octanisorg/Octanis5-Rack_MOSFET_driver/RPi_Hat.xlsx

Location | MPN/Seeed SKU | QTY
C1, C2 | 100u | 2
D1, D2, D3, D4, D5, D6, D7, D8 | MMSZ5237B-7-F | 8
D9, D10, D11, D12, D13, D14, D15, D16 | FM4004-W | 8
D25 | 1N5819HW-7-F | 1
Q1, Q2, Q3, Q4, Q5, Q6, Q7, Q8 | TSM3404 | 8
R1, R2, R3, R4, R5, R6, R7, R8 | 1k5 | 8
R9, R10, R11, R12, R13, R14, R15, R16 | 18k | 8
R17, R18, R19, R20, R21, R22, R23, R24 | 4k7 | 8
U1, U2, U3, U4, U5, U6, U7, U8 | VO615A-3 | 8
