octanisorg/Octanis5-Rack_MOSFET_driver/RPi_Hat.kicad_pcb

## KiCad design RPi_Hat.kicad_pcb (2017-12-09)

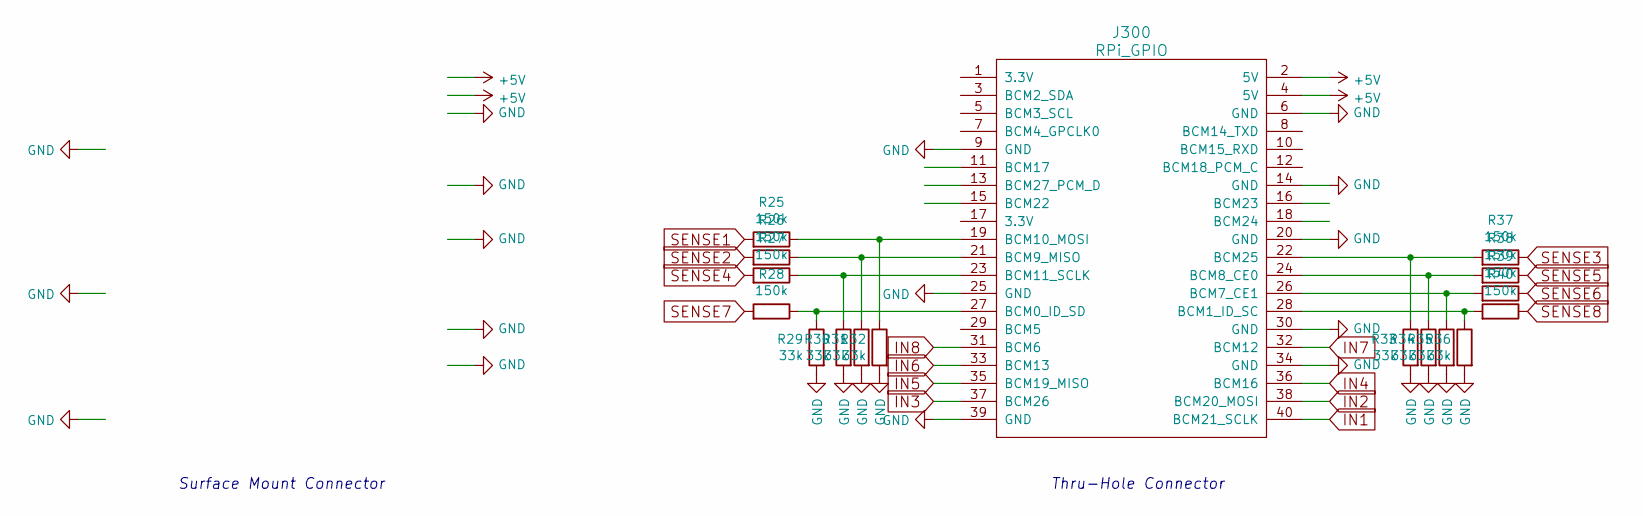
[picture p1: schematic RPi_GPIO.sch]

Parts:
J300: RPi_GPIO; Pin_Header_Straight_2x20; LCSC P/N C50982
R25, R26, R27, R28, R37, R38, R39, R40: 150k; R_0603; LCSC P/N C22807
R29, R30, R31, R32, R33, R34, R35, R36: 33k; R_0603; LCSC P/N C4216

Connections:
+5V: J300.2 (5V), J300.4 (5V); also elsewhere on the board
GND: J300.6 (GND), J300.9 (GND), J300.14 (GND), J300.20 (GND), J300.25 (GND), J300.30 (GND), J300.34 (GND), J300.39 (GND), R29.2, R30.2, R31.2, R32.2, R33.2, R34.2, R35.2, R36.2; also elsewhere on the board
IN1: J300.40 (BCM21_SCLK); also elsewhere on the board
IN2: J300.38 (BCM20_MOSI); also elsewhere on the board
IN3: J300.37 (BCM26); also elsewhere on the board
IN4: J300.36 (BCM16); also elsewhere on the board
IN5: J300.35 (BCM19_MISO); also elsewhere on the board
IN6: J300.33 (BCM13); also elsewhere on the board
IN7: J300.32 (BCM12); also elsewhere on the board
IN8: J300.31 (BCM6); also elsewhere on the board
unnamed: J300.19 (BCM10_MOSI), R25.1, R32.1
unnamed: J300.21 (BCM9_MISO), R26.1, R31.1
unnamed: J300.22 (BCM25), R33.1, R37.2
unnamed: J300.23 (BCM11_SCLK), R27.1, R30.1
unnamed: J300.24 (BCM8_CE0), R34.1, R38.2
unnamed: J300.26 (BCM7_CE1), R35.1, R39.2
unnamed: J300.27 (BCM0_ID_SD), R28.1, R29.1
unnamed: J300.28 (BCM1_ID_SC), R36.1, R40.2
SENSE1: R25.2; also elsewhere on the board
SENSE2: R26.2; also elsewhere on the board
SENSE3: R37.1; also elsewhere on the board
SENSE4: R27.2; also elsewhere on the board
SENSE5: R38.1; also elsewhere on the board
SENSE6: R39.1; also elsewhere on the board
SENSE7: R28.2; also elsewhere on the board
SENSE8: R40.1; also elsewhere on the board

Notes on the sheet:
Surface Mount Connector
Thru-Hole Connector

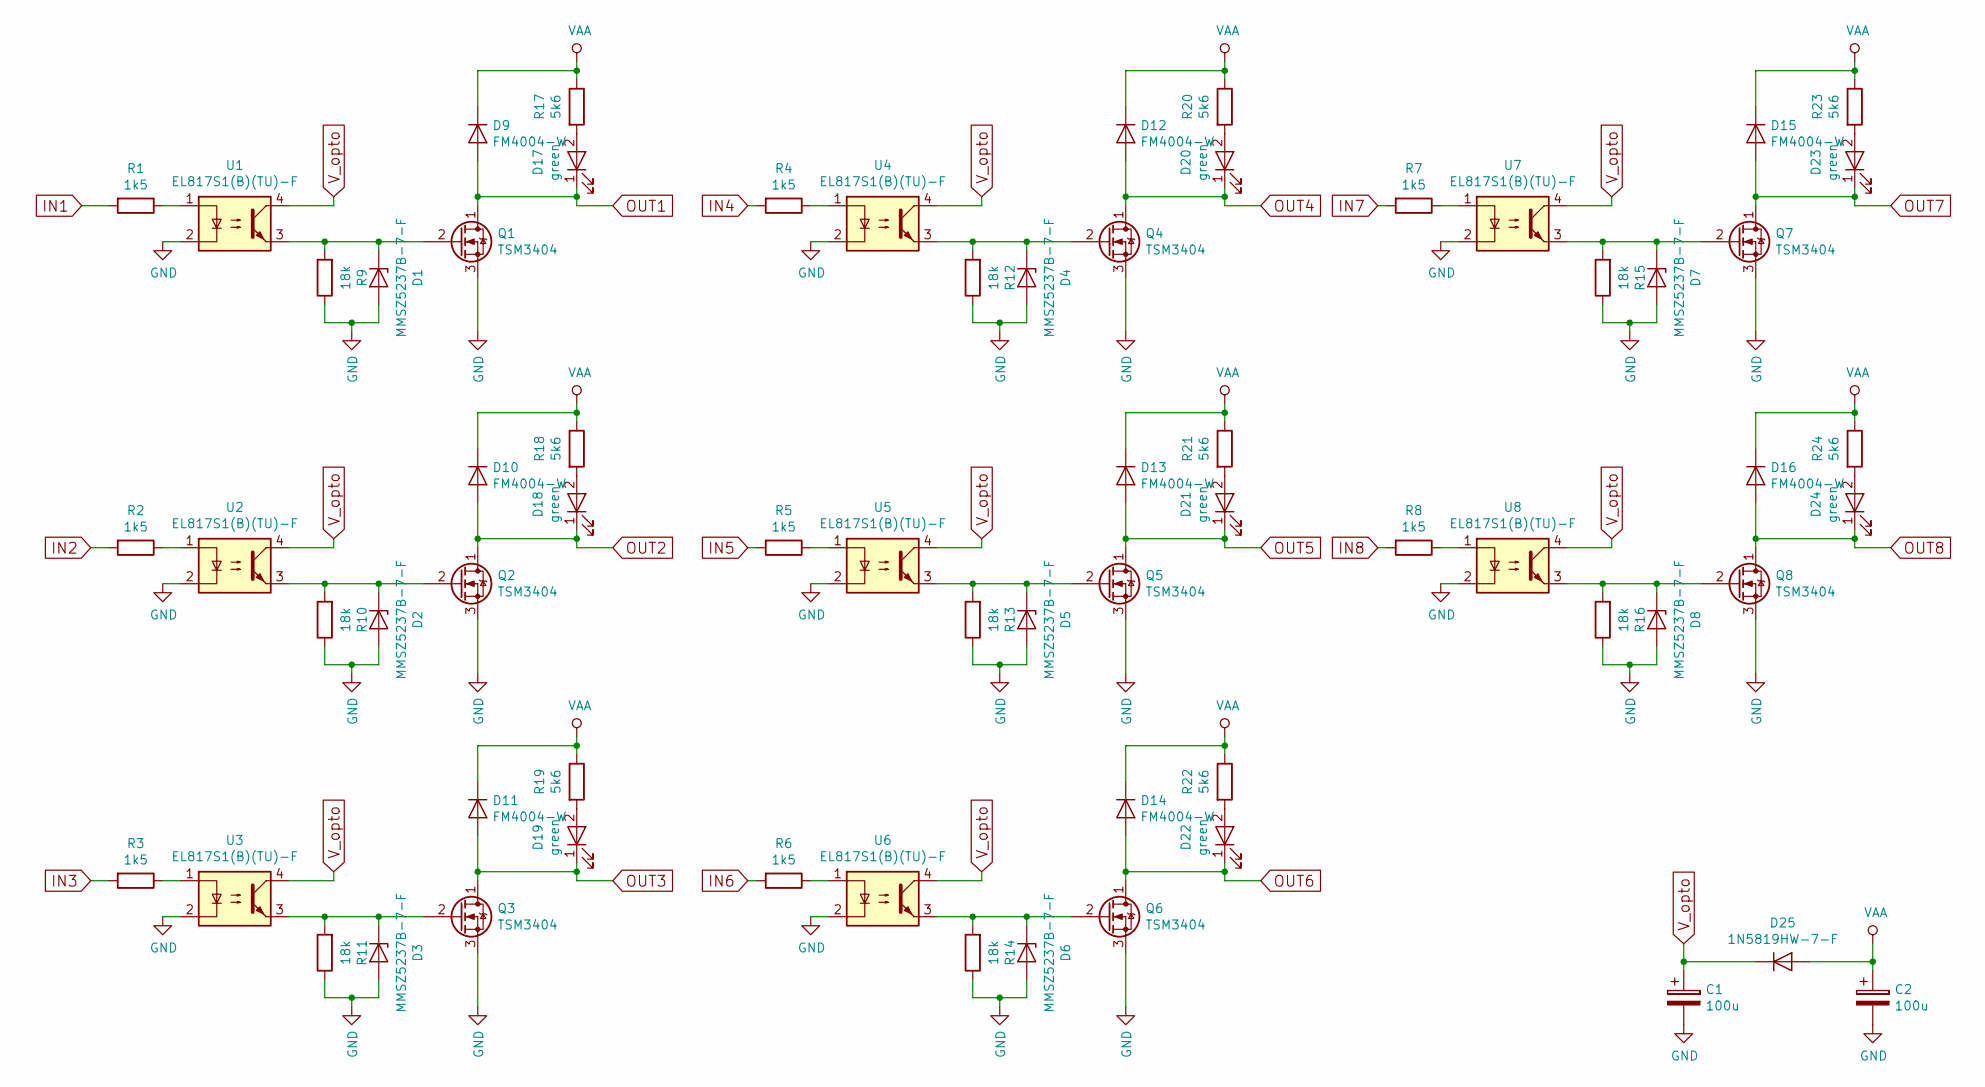
[picture p2: schematic mosfet_driver_8chan.sch]

Parts:
C1, C2: 100u; C_Radial_D8_L13_P3.8; LCSC P/N C45674
D1, D2, D3, D4, D5, D6, D7, D8: MMSZ5237B-7-F; SOD-123; LCSC P/N C65078
D9, D10, D11, D12, D13, D14, D15, D16: FM4004-W; SMB_Standard; LCSC P/N C122842
D17, D18, D19, D20, D21, D22, D23, D24: green; LED_0603; LCSC P/N C118334
D25: 1N5819HW-7-F; SOD-123; LCSC P/N C82544
Q1, Q2, Q3, Q4, Q5, Q6, Q7, Q8: TSM3404; SOT-23; LCSC P/N C71151
R1, R2, R3, R4, R5, R6, R7, R8: 1k5; R_0603; LCSC P/N C138275
R9, R10, R11, R12, R13, R14, R15, R16: 18k; R_0603; LCSC P/N C100821
R17, R18, R19, R20, R21, R22, R23, R24: 5k6; R_0603; LCSC P/N C101368
U1, U2, U3, U4, U5, U6, U7, U8: EL817S1(B)(TU)-F; EL817S1-B-TU-F; LCSC P/N C63268

Connections:
GND: C1.2, C2.2, D1.2 (A), D2.2 (A), D3.2 (A), D4.2 (A), D5.2 (A), D6.2 (A), D7.2 (A), D8.2 (A), Q1.3 (S), Q2.3 (S), Q3.3 (S), Q4.3 (S), Q5.3 (S), Q6.3 (S), Q7.3 (S), Q8.3 (S), R9.1, R10.1, R11.1, R12.1, R13.1, R14.1, R15.1, R16.1, U1.2, U2.2, U3.2, U4.2, U5.2, U6.2, U7.2, U8.2; also elsewhere on the board
IN1: R1.2; also elsewhere on the board
IN2: R2.2; also elsewhere on the board
IN3: R3.2; also elsewhere on the board
IN4: R4.2; also elsewhere on the board
IN5: R5.2; also elsewhere on the board
IN6: R6.2; also elsewhere on the board
IN7: R7.2; also elsewhere on the board
IN8: R8.2; also elsewhere on the board
unnamed: D1.1 (K), Q1.2 (G), R9.2, U1.3
unnamed: D2.1 (K), Q2.2 (G), R10.2, U2.3
unnamed: D3.1 (K), Q3.2 (G), R11.2, U3.3
unnamed: D4.1 (K), Q4.2 (G), R12.2, U4.3
unnamed: D5.1 (K), Q5.2 (G), R13.2, U5.3
unnamed: D6.1 (K), Q6.2 (G), R14.2, U6.3
unnamed: D7.1 (K), Q7.2 (G), R15.2, U7.3
unnamed: D8.1 (K), Q8.2 (G), R16.2, U8.3
unnamed: D17.2 (A), R17.2
unnamed: D18.2 (A), R18.2
unnamed: D19.2 (A), R19.2
unnamed: D20.2 (A), R20.2
unnamed: D21.2 (A), R21.2
unnamed: D22.2 (A), R22.2
unnamed: D23.2 (A), R23.2
unnamed: D24.2 (A), R24.2
unnamed: R1.1, U1.1
unnamed: R2.1, U2.1
unnamed: R3.1, U3.1
unnamed: R4.1, U4.1
unnamed: R5.1, U5.1
unnamed: R6.1, U6.1
unnamed: R7.1, U7.1
unnamed: R8.1, U8.1
OUT1: D9.2 (A), D17.1 (K), Q1.1 (D); also elsewhere on the board
OUT2: D10.2 (A), D18.1 (K), Q2.1 (D); also elsewhere on the board
OUT3: D11.2 (A), D19.1 (K), Q3.1 (D); also elsewhere on the board
OUT4: D12.2 (A), D20.1 (K), Q4.1 (D); also elsewhere on the board
OUT5: D13.2 (A), D21.1 (K), Q5.1 (D); also elsewhere on the board
OUT6: D14.2 (A), D22.1 (K), Q6.1 (D); also elsewhere on the board
OUT7: D15.2 (A), D23.1 (K), Q7.1 (D); also elsewhere on the board
OUT8: D16.2 (A), D24.1 (K), Q8.1 (D); also elsewhere on the board
VAA: C2.1, D9.1 (K), D10.1 (K), D11.1 (K), D12.1 (K), D13.1 (K), D14.1 (K), D15.1 (K), D16.1 (K), D25.2 (A), R17.1, R18.1, R19.1, R20.1, R21.1, R22.1, R23.1, R24.1; also elsewhere on the board
V_opto: C1.1, D25.1 (K), U1.4, U2.4, U3.4, U4.4, U5.4, U6.4, U7.4, U8.4

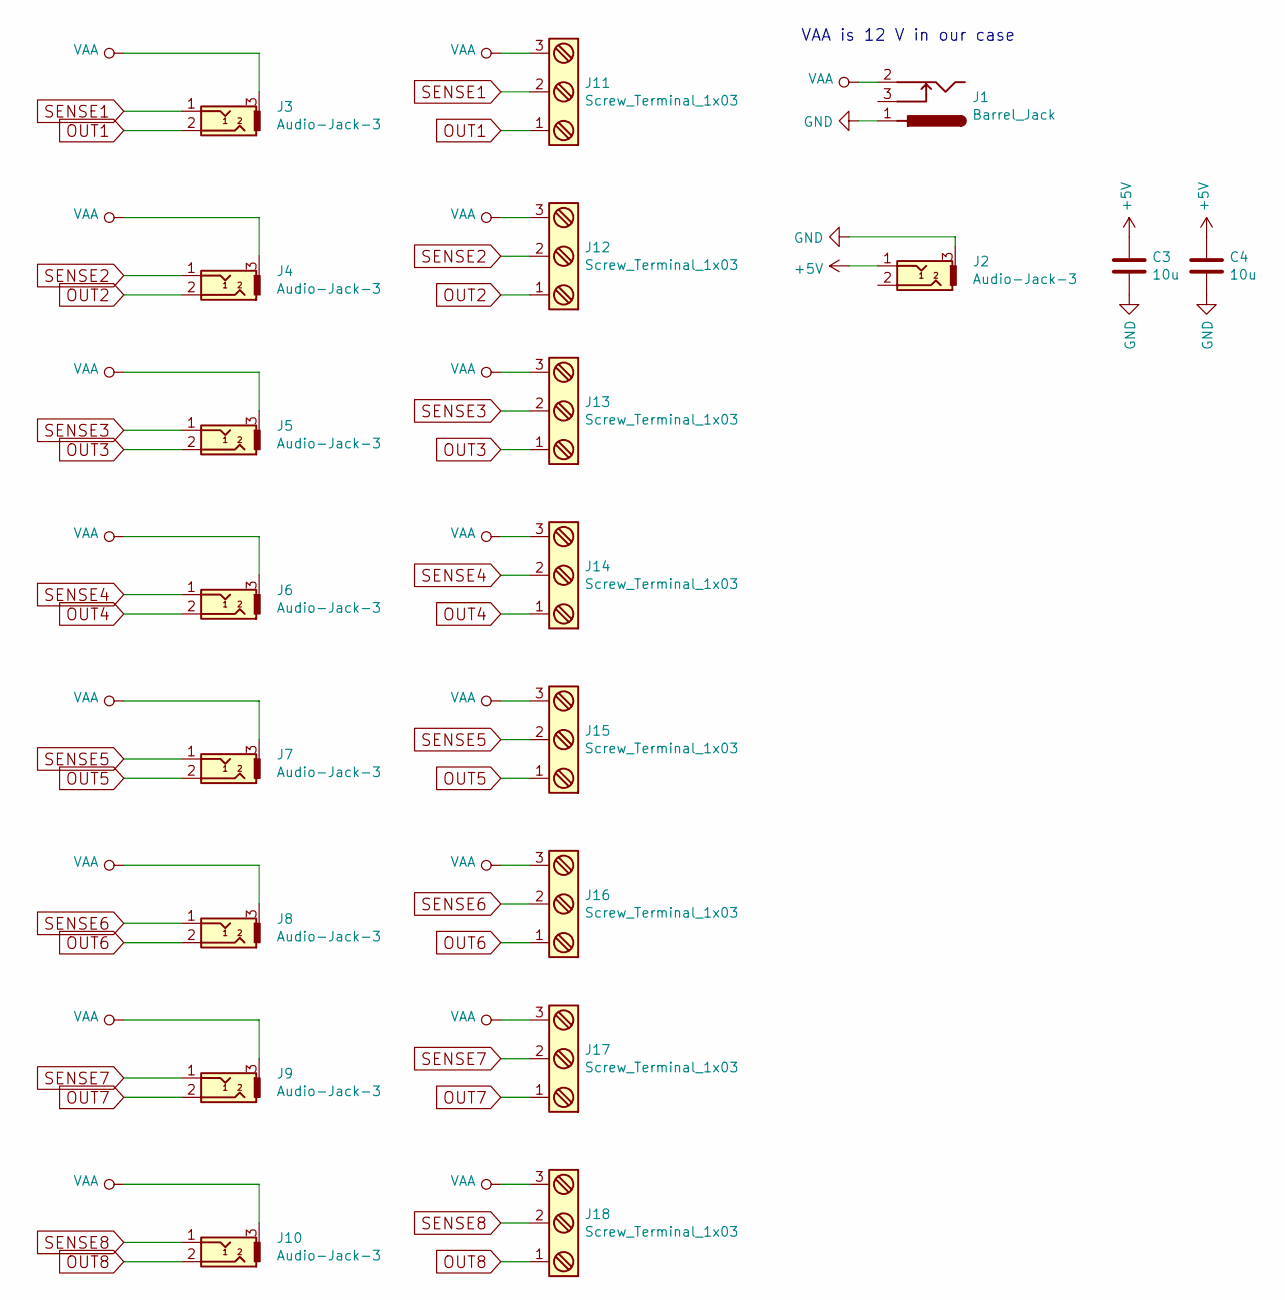
[picture p3: schematic rack_driver_connectors.sch]

Parts:
C3, C4: 10u; C_0805; LCSC P/N C123631
J1: Barrel_Jack; DC-005-20A; LCSC P/N C136744
J2, J3, J4, J5, J6, J7, J8, J9, J10: Audio-Jack-3; PJ-313D; LCSC P/N C95463
J11, J12, J13, J14, J15, J16, J17, J18: Screw_Terminal_1x03; JST_PH_B3B-PH-K_03x2.00mm_Straight; LCSC P/N C10400

Connections:
+5V: C3.1, C4.1, J2.1; also elsewhere on the board
GND: C3.2, C4.2, J1.1, J2.3; also elsewhere on the board
OUT1: J3.2, J11.1; also elsewhere on the board
OUT2: J4.2, J12.1; also elsewhere on the board
OUT3: J5.2, J13.1; also elsewhere on the board
OUT4: J6.2, J14.1; also elsewhere on the board
OUT5: J7.2, J15.1; also elsewhere on the board
OUT6: J8.2, J16.1; also elsewhere on the board
OUT7: J9.2, J17.1; also elsewhere on the board
OUT8: J10.2, J18.1; also elsewhere on the board
SENSE1: J3.1, J11.2; also elsewhere on the board
SENSE2: J4.1, J12.2; also elsewhere on the board
SENSE3: J5.1, J13.2; also elsewhere on the board
SENSE4: J6.1, J14.2; also elsewhere on the board
SENSE5: J7.1, J15.2; also elsewhere on the board
SENSE6: J8.1, J16.2; also elsewhere on the board
SENSE7: J9.1, J17.2; also elsewhere on the board
SENSE8: J10.1, J18.2; also elsewhere on the board
VAA: J1.2, J3.3, J4.3, J5.3, J6.3, J7.3, J8.3, J9.3, J10.3, J11.3, J12.3, J13.3, J14.3, J15.3, J16.3, J17.3, J18.3; also elsewhere on the board

Notes on the sheet:
VAA is 12 V in our case

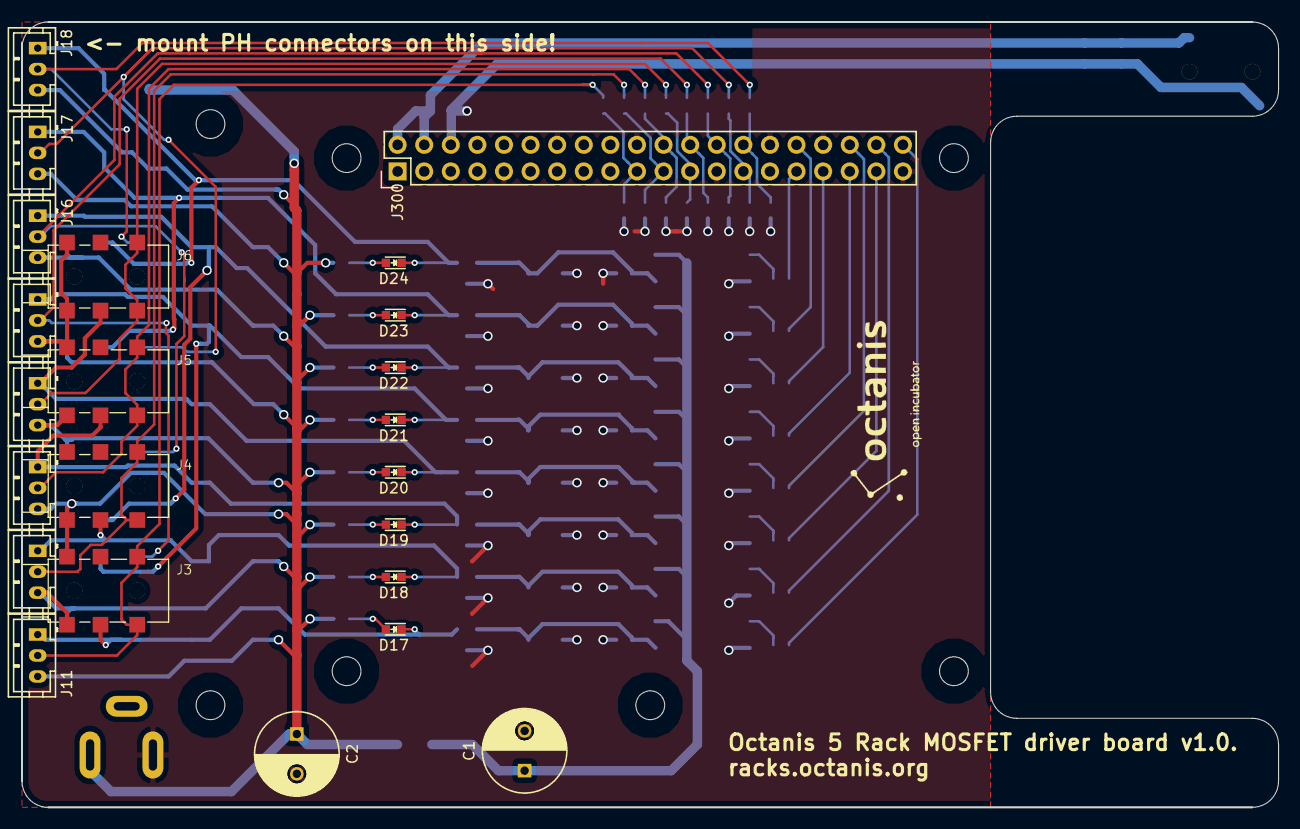
[picture p4: board RPi_Hat.kicad_pcb from above]

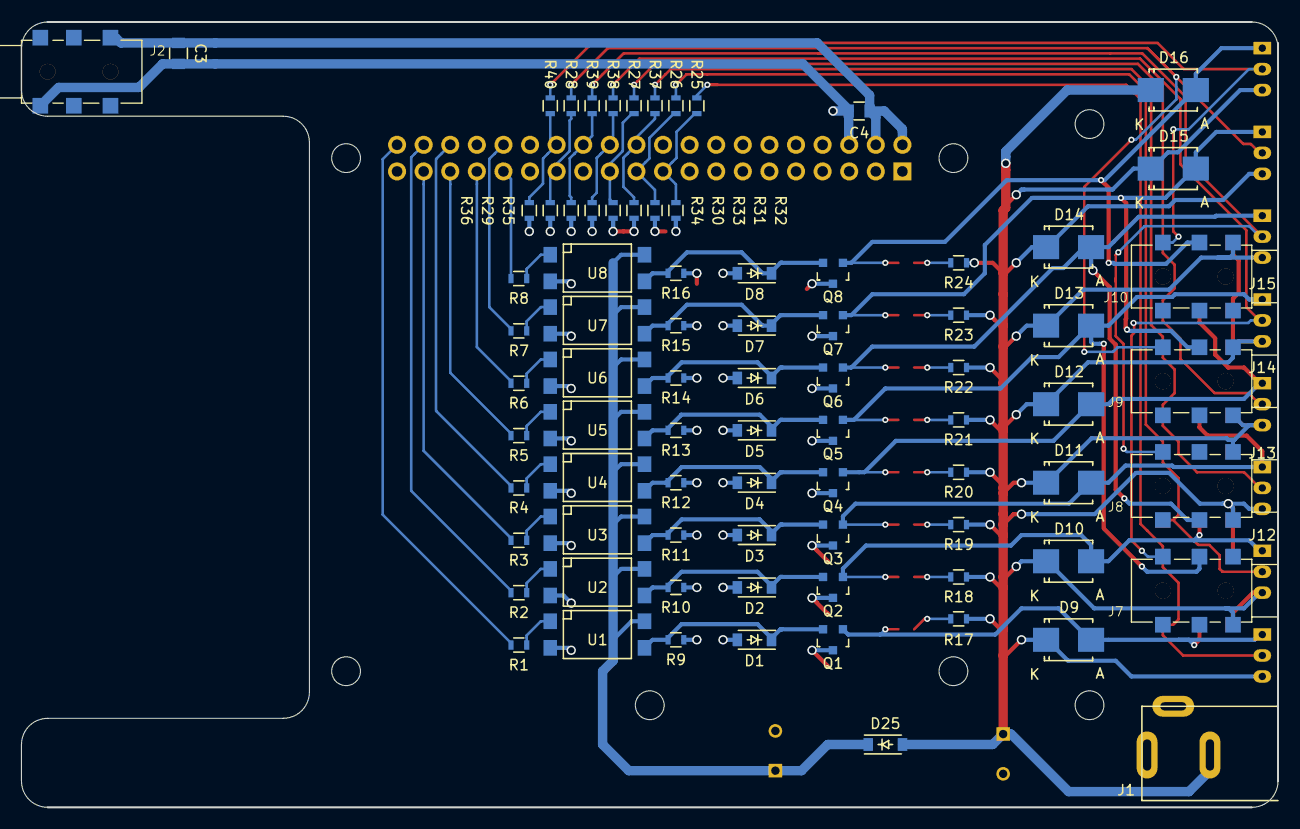
[picture p5: board RPi_Hat.kicad_pcb from below]

Board: 2 copper layers, 120.0 x 75.0 mm, 104 parts (81 on the bottom side), 60 nets.
