octanisorg/Octanis5-Rack_MOSFET_driver/(commit log)

2017-12-04 schematic done. PCB outline done. need to replace jack footprint
    [RPi_Hat.csv, RPi_Hat.xlsx, RPi_Hat1.csv, mosfet_driver_8chan.sch, rack_driver_connectors.sch]
2017-12-04 halfway routed
    [RPi_GPIO.sch, RPi_Hat.kicad_pcb, mosfet_driver_8chan.sch, rack_driver_connectors.sch]
2017-12-08 finished component placement
    [RPi_GPIO.sch, RPi_Hat.kicad_pcb, rack_driver_connectors.sch]
2017-12-08 finished routing
    [RPi_GPIO.sch, RPi_Hat.kicad_pcb, mosfet_driver_8chan.sch, rack_driver_connectors.sch]
2017-12-09 final PCB as ordered
    [RPi_GPIO.sch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]
